fernando-senna/SoundDetector/Project Pictures/front.png

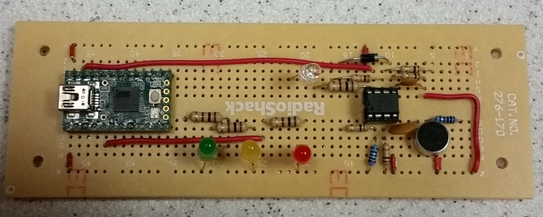
Project Pictures/front.png
